hannaashkar/rv32i_cpu/docs/DEMO.md

# On-board demos — DE10-Lite quick guide

How to flash and drive the two board demos. The flashing procedure and the
LED walker are hardware-proven (2026-07-11); the MNIST demo is
lockstep-verified in simulation on both cores — its first board flash is
the acceptance step. **The MNIST bitstream now builds** — D024 first made
the design routable by moving the gshare PHT into M9Ks; D025 then moved the
6R/3W PRF into 18 M9Ks, D026 balanced the LQ selector, D027 balanced the SQ
selector, and D028 replaced the IQ port-1 clear-and-repick chain with a
cycle-exact top-two tree. D029 then proved that the memory/load-WB arm of the
generic EX bypass could never win, added a permanent source-use oracle, and
removed the dead mux input without changing a cycle.

The current production RTL top is merged and pushed at baseline **`3c3171f`**
(GitHub Actions run **29368469898 green**). It fits at **34,945 / 49,760 LEs
(70%)**, uses **15,140 registers, 632,444 memory bits, and 16 multiplier
elements**, and reaches **31.29 MHz** slow-85C Fmax. The actual PLL-/2 build
closes at **25 MHz** with **+8.045 ns** slow-85C setup slack; hold, recovery,
and removal are also positive, and every path is constrained. Both full
lockstep gates pass, and line coverage is **99.3% (1596/1607)** across 61
programs per core. Freshness-clean D029 MNIST `.sof` and `.pof` images were
assembled from MIF stamp `mlp`, but remain **unflashed**. No JTAG hardware was
available on 2026-07-15. Hardware truth is still the earlier 16.67 MHz
LED-walker/CFM image; MNIST has not run on silicon. Before
D024 it failed to route at 96% LEs — if you are on an older checkout and hit
"Can't route", that is why. If anything surprises you, the board state
section at the bottom is the first thing to check.

The board top (`rtl/top/de10_top.v`) is the **2-wide out-of-order core**
with the store-set predictor and the NPU. The current source is configured for
**25 MHz** (PLL /2 from the 50 MHz oscillator); this is timing-clean but not
yet hardware-confirmed. It is a 50% configured-clock increase over the
hardware-proven 16.67 MHz image. Which *program* the FPGA runs is decided at
compile time by the MIF images in `synth/`:

| `make` target | Program in the bitstream |
|---|---|
| `make mif` (default) | **MNIST demo** — switch-selected digit recognition |
| `make mif MIF_PROG=demo` | LED walker (the D022 bring-up acceptance test) |

After switching MIFs, recompile in Quartus (Processing → Start Compilation)
and reflash. The `.mif` files are checked in, so a fresh clone builds the
MNIST demo without any software toolchain.

## Flashing (Quartus Programmer GUI)

1. Board on, USB cable in. Open Quartus → **Tools → Programmer**.
2. **Hardware Setup…** → select `USB-Blaster [USB-0]` → Close.
   (Missing? Install the driver from
   `C:\intelfpga_lite\20.1\quartus\drivers\usb-blaster` via Device Manager.)
3. **Auto Detect** → the chain shows one `10M50DA` device.
4. **Change File…** → `synth/output_files/rv32i_cpu.sof` → tick
   **Program/Configure** → **Start**. Seconds later the design is live.
   `.sof` = volatile: lost on power-cycle.
5. To make it permanent: **Change File…** → `rv32i_cpu.pof`, tick
   **Program/Configure** + **Verify**, **Start** (~1 min). The design now
   boots from the MAX 10's internal flash on power-up, no PC needed.

CLI equivalent, from `synth/`:
`quartus_pgm -m jtag -o "p;output_files/rv32i_cpu.sof"` (or `"pv;...pof"`).

## The MNIST demo (D023)

At power-up / reset (KEY0) the program first **self-tests**: it classifies
all 8 built-in images and lights one LED per image as a progress bar. Then
it enters the interactive loop:

- **SW[2:0]** selects one of 8 handwritten-digit images (from the MNIST
  test set, baked into the data memory at synthesis).
- The CPU drives the NPU through the two matrix multiplies of a quantized
  784→32→10 network (~47k cycles ≈ 1.9 ms at the configured 25 MHz;
  simulation-derived until the board acceptance run) and shows:

```
  HEX5          HEX2      HEX0
  image number  label     prediction
  (switches)    (truth)   (the network's answer)
```

- **LEDR9** lights when prediction == label. **LEDR[7:0]** shows which
  image is selected. With the shipped weights all 8 images classify
  correctly, so HEX2 and HEX0 always match — flip switches and watch the
  answer track the truth.

Once flashed, this will exercise end-to-end on silicon: the banked M9K
instruction ROM, the MIF-initialized 64 KB block-RAM data memory (weights
present at power-up — there is no loader), the OoO core's IO-ordering
interlocks against a busy NPU, the systolic array itself, and the new
7-segment MMIO path. Until that acceptance step, these are simulation +
fit/STA claims, not an on-board inference claim. The same binary's self-test
phase runs in the Verilator regression
(`make npu-mlp-board[-ooo]`), lockstep-compared against the golden model.

## The LED walker (D022 bring-up test)

A single lit LED walks LEDR0→LEDR9 and back, self-paced in software.
Boring on purpose: every instruction fetch crosses the even/odd M9K banks
and the parity crossbar, so a steady walk is the acceptance test for the
banked instruction memory. Use it when bisecting a board problem — if the
walker runs, fetch/PLL/timing are healthy.

## Board state notes

- Displays dark + LEDs dead → press KEY0 (reset). Still dead → reflash.
- The last documented `.pof` programmed and verified in the MAX 10 flash is
  the earlier 16.67 MHz OoO LED walker/CFM image—not D029 and not MNIST
  inference. Check `git log synth/` to correlate any later manually
  programmed bitstream.
- As of 2026-07-15 no JTAG hardware was available, so the production 25 MHz
  `.sof`/`.pof` could not yet be accepted on the physical board.
- Pin assignments in `synth/rv32i_cpu.qsf` are copied from the proven
  build and are **not to be edited**; the HEX0-5 pins (added 2026-07-11,
  D023) were verified against two independent DE10-Lite references.
