hannaashkar/rv32i_cpu/docs/AUDIT-2026-07-11.md

# Full-project audit — 2026-07-11

Method: 8-dimension multi-agent audit (RTL area, timing, Quartus settings,
build system, verification, software, docs, hygiene); every medium/high
finding adversarially verified against the actual files/reports by an
independent checker before inclusion. 65 raw findings → **36 confirmed**,
2 refuted (both were already-documented deliberate calls), 27 minor.

Evidence base: the FAILED D023 fit (`synth/output_files/rv32i_cpu.fit.rpt`,
routing congestion at 96% LEs, A&S 53,200 LEs) — first time the per-entity
resource table was actually read.

Legend: **[H]**anna decision (microarchitecture) / **[C]**laude
(infrastructure). Status boxes updated as items land.

**Current production status (2026-07-15):** verification hardening and
D026–D029 are merged and pushed at RTL baseline **`3c3171f`**. GitHub Actions
run **29368469898 is green**. The complete
pre-merge feature stack is backed up on origin as `codex/load-wb-bypass-cut`
at **`fe3cfb0`**. Fresh PLL-/2 25 MHz MNIST programming files exist but remain
unflashed because no JTAG hardware was available on 2026-07-15. The physical
truth remains the earlier 16.67 MHz OoO LED-walker/CFM image.

---

## 1. Strategy-changing discoveries (area)

The per-entity fitter table rewrites the shrink plan — there are TWO LE pigs,
not one, and together they are ~44% of the 10M50:

| Entity | Fitted LCs | Regs | Root cause |
|---|---|---|---|
| `gshare_bp:BP0` | **11,137** (fit.rpt:1440) | 5,926 | PHT-side read/update networks; PHT duplicated per read port |
| `ooo_prf:PRF0` | **10,947** (fit.rpt:1507) | 2,048 | 64×32 flop array, 6 async read ports (`rd_bypass`, ooo_prf.v:35-51), 3 write ports |
| `ooo_iq:IQ0` | 8,378 (historical D023 audit); **8,565 on D028** | 2,720 | 162-bit uop payload muxed 16:1 on 3 select ports; D028 top-two timing tree adds no state |
| flat `ooo_cpu` | 14,132 | — | incl. ~3k LEs of RAT checkpoints (8×192b + dual rat_after0/1 snapshot networks, ooo_cpu.v:438,601-611) |

- [x] **[H] gshare shrink — CORRECTED AIM.** The BTB data arrays are
  **already M9K** in this build (btb_target/btb_tag/btb_cond each show
  0 LCs — Quartus auto-mapped altsyncram). The 11,137 LCs are PHT-side.
  Design options must target the PHT read/update path — not the BTB.
  **DONE 2026-07-12 (D024, branch `gshare-m9k-pht`): Hanna picked A1;
  even/odd banked M9K PHT shipped. A&S 53,200 → 46,620 LEs (−6,580,
  12.4% of the device), registers 18,976 → 16,995, PHT in 2 M9Ks.
  CoreMark IPC 1.026 KEPT (official CRCs, 432.8M instructions lockstep-
  clean); OoO 19/19+40/40+25/25+25/25-vio. INV-G1 + INV-G2 self-checks
  armed. Board fit re-run to unblock the D023 demo.** See DECISIONS.md
  D024 / docs/GSHARE_SHRINK.md.
- [x] **[H] PRF → M9K via LVT replication — DONE D025.** 18 M9K banks +
  register LVT + folded reads + exact direct/shadow write-first bypass;
  **−8,895 LEs (43,609 → 34,714, 88% → 70%)**, IPC/cycles unchanged.
  See DECISIONS D025 and `docs/PRF_SHRINK.md`.
- [ ] **[H] IQ payload split** (wakeup array vs payload RAM). 111 of the
  162 uop bits (U_IMM/U_PC/U_PNPC/U_GHR/U_RS1A) are never consulted by
  scheduling logic — classic payload-RAM split. Est. ~3k LEs; also
  de-risks the future 2-stage scheduler (less state to pipeline).
- [ ] **[H] Checkpoint slimming**: NCHKPT=4 (A/B the dispatch-stall cost),
  or M9K checkpoint file (+1 mispredict cycle), or drop the second
  same-cycle checkpoint port (delete rat_after1 network). ~1-3k LEs.
- [ ] **[C] Async resets on pure payload arrays** (IQ `u[]`, ex_a/ex_b,
  wb_val, dr_* payload, SQ addr/data, rob_pc — ooo_iq.v:270-276,
  ooo_cpu.v:1167-1193, ooo_sq.v:157-164) block RAM extraction and bloat
  the reset net. Valid-bit reset alone is architecturally sufficient.
  Mechanical, lockstep-verifiable, one module per commit — but Hanna
  ACKs the list first (X-semantics change in 4-state sims).

Delivered result from the two dominant storage conversions plus the D026 LQ,
D027 SQ, D028 IQ trees, and D029 dead-bypass cut: the routed production MNIST
board top is **34,945 LEs (70%)**, with routing slack restored. D029's full
verification, coverage, reportable CoreMark, and production CI gates are green.
Actual PLL-/2 fit/STA closes at 25 MHz with +8.045 ns slow-85C setup slack;
fresh MNIST `.sof`/`.pof` images are assembled and freshness-clean but
unflashed.

## 2. Timing truths

- [x] **[C] Re-run fit + STA after the storage shrinks.** D025 reported
  **23.51 MHz Fmax** and +17.47 ns slack at the 16.67 MHz board clock.
  All top-20 paths crossed the ~41.9 ns `dmem → load bypass → store AGU →
  LQ oldest-match → rob_poison` chain.
- [x] **[H] LQ violation-path redesign — DONE D026.** The serial selector is
  now an exact 8→4→2→1 parallel match/min-age tree with the old scan retained
  as a simulation oracle. Fmax **23.51 → 25.10 MHz (+6.8%)**; LQ is absent
  from all top-20 paths. B015 was found and fixed by the new LQ unit model.
- [x] **[H] SQ forwarding/replay selector — DONE D027.** The serial
  youngest-older scan is now an exact parallel-candidate + balanced 8→4→2→1
  max-age tree. The old scan remains a live Verilator oracle. `sq-tb` passes
  300,087 cycles / 300,088 queries / 45,313 forwards / 90,252 conflicts /
  36,668 drains / 2,382 flushes, including mandatory occupancy 0–8,
  one/two/final-slot allocation, SB/SH/SW, multi-match, backpressure,
  flush/wrap, and winner-leaf 0–7 bins. SQ cost is 924 mapped combinational
  LEs / 596 registers and 1,024 total fitted LCs / 596 registers; no serial SQ
  node remains in the top 20. Both cores pass 20/20 directed+C, 40/40 rv32ui, 25/25
  base/system/NPU random, and 80/80 X-state runs; OoO also passes 25/25
  violation stress. Official reportable CoreMark is cycle-identical at
  1.422552 CoreMark/MHz, IPC 1.026, 506,197,207 cycles, and 519,453,600
  lockstep comparisons.
- [x] **[H] IQ port-1 select rewrite — D028 ROUTED + FULL GATES GREEN.**
  D027's 38.744 ns / 32-level top-20 family was the dependent
  `pick → clear → repick` path. D028 computes the oldest two ALU candidates in
  one balanced sorted-pair tree. INV-I1 retains the old topology as a live
  oracle; `iq-tb` passes 300,553 cycles / 74,571 complete-payload checks and
  every 3×16 winner leaf. Fmax is **27.02 MHz**, and the IQ is absent from all
  top-20 paths. Both cores pass 20/20 directed+C, 40/40 rv32ui, 25/25
  base/system/NPU random, and 80/80 X/reset; OoO additionally passes all three
  queue unit models and 25/25 violation stress, with zero lockstep divergence.
  Fresh coverage is 99.2% (1522/1534), 60 programs per core, zero failures;
  every D028 IQ addition is covered. Reportable 720-iteration CoreMark is
  cycle-exact to D027 at 1.422552 CoreMark/MHz, IPC 1.026, 506,197,207
  full-run cycles, and 519,453,600 lockstep comparisons, with official CRCs,
  reportable validation, and zero divergence. D028's merge gate is complete.
- [x] **[H] D029 load/JALR/redirect/PHT path — DEAD WB2 ARM CUT, FULL GATES
  GREEN.** The measured cone crossed the generic WB2 load-result EX bypass.
  Edge-by-edge scheduling/PRF proof showed that the load has already left WB
  before its earliest consumer reaches EX, so D029 removes only WB2 while
  retaining WB0/WB1. A permanent ROB-tagged exact source-use oracle models the
  former bypass priority and fatals if WB2 could win. Full verification and
  reportable CoreMark cover all six select-port/source bins with **zero WB2
  hits**; `load_wb_bypass.S` adds 24 focused checks. `hello.c` and CoreMark are
  cycle-exact. The old dmem family is absent from D029's top 20.
- [ ] **[H] True 2-stage issue-queue scheduler / readiness cut — NEW D029
  LIMITER.** D029's top-20 family is `rob_head → IQ readiness/operand select`,
  worst 31.517 ns. A registered scheduler remains a valid higher-frequency
  option, but its latency/IPC cost must be compared with a smaller relage/head
  dependency cut before changing the public issue timing.
- [x] **[H] D027 clock decision.** Keep the board at PLL /3 (16.67 MHz).
  D027 fits at 34,787 LEs / 95 M9Ks with Fmax 25.47 MHz, +20.745 ns setup at
  /3, +0.337 ns worst hold, every timing check positive, and zero
  unconstrained paths. That implies only **0.745 ns theoretical setup margin**
  at PLL /2, below the ≥3 ns slow-85C gate, so a /2 build was not attempted.
  Fresh /3 `.sof` and `.pof` images were assembled. Reconsider /2 after the IQ
  redesign.
- [x] **[H] D028 clock decision.** Keep PLL /3 again. D028 fits at 35,096 LEs
  with Fmax 27.02 MHz and +22.994 ns setup at /3; hold +0.372 ns, recovery
  +52.869 ns, removal +1.653 ns, every timing class positive, and zero
  unconstrained paths. Subtracting the 20 ns period change for PLL /2 leaves
  **+2.994 ns theoretical margin**, narrowly below the ≥3 ns gate. No D028
  /2 claim was made. A final post-RTL map+fit rerun exactly reproduced the
  documented numerical results; assembly
  at 22:44:32 completed with 0 errors / 0 warnings from MIF stamp `mlp`.
  Freshness-clean D028 MNIST `.sof`/`.pof` exist but remain unflashed, so
  hardware truth remains the earlier LED-walker/CFM image.
- [x] **[H] D029 clock decision — PROMOTE TO PLL /2 (25 MHz).** The post-cut
  PLL-/3 characterization reached Fmax 29.14 MHz and projected +5.678 ns at
  /2, clearing the predeclared gate. The actual PLL-/2 build then fit at
  **34,945/49,760 LEs (70%)**, restricted Fmax **31.29 MHz**, slow-85C setup
  **+8.045 ns**, hold **+0.339 ns**, recovery +34.440 ns, removal +1.506 ns,
  every timing class positive, and zero unconstrained paths. Assembly produced
  fresh MNIST `.sof`/`.pof` images. This is a verified 50% clock increase over
  /3 in the build evidence, but it remains unflashed; hardware truth is still
  the earlier 16.67 MHz OoO LED-walker/CFM image.
- [x] **[C] No fit/STA make target, no critical-path archiving** → added
  (`make synth-fit` / `synth-sta`, see Makefile).

## 3. Board-fit toolbox (next D023 compile attempt)

- [x] **[C] Router/placement effort knobs** (all were defaults on a
  routing-failing design): ROUTER_TIMING_OPTIMIZATION_LEVEL MINIMUM,
  PLACEMENT_EFFORT_MULTIPLIER 4.0, ROUTER_EFFORT_MULTIPLIER 4.0.
- [x] **[C] Area-driven synthesis knobs — A/B result: mostly a DEAD
  END.** `OPTIMIZATION_TECHNIQUE Area`/`AREA` is silently ignored by
  quartus_map for this MAX 10 project (settings report stays "Balanced",
  netlist bit-identical at 53,200 LEs under both spellings — do not
  re-add). `AUTO_RESOURCE_SHARING ON` applies and is LE-neutral here
  (kept; free on future RTL). The LE relief must come from the RTL
  levers in §1, not synthesis settings.
- [ ] **[C] dmem maximum_depth hint**: 64 M9Ks currently scattered across
  all 3 columns × full die height (fit.rpt:2299). Try
  `maximum_depth=2048` (or 1024) to reshape address/byte-enable fanout.
  NOTE: the old "8192" idea is a likely no-op (verified).
- [x] **[C] NUM_PARALLEL_PROCESSORS ALL** (was capping at 10/16 cores,
  warning every run).
- [x] **[C] ModelSim EDA netlist generation OFF** (45 MB synth/simulation
  per compile, project simulates only with Verilator).
- [x] **[C→H] Redundant unindexed KEY IO_STANDARD assignment** — DONE
  2026-07-12 with Hanna's explicit approval (one duplicate line removed,
  KEY[0]/KEY[1] and all location assignments untouched).
- Refuted/parked (already-documented gambles, do not re-litigate): image
  trim 32→8 (D023 gamble shelf), seed sweep (placement already escalated
  internally; failure is structural).

## 4. Verification gaps

- [x] **[C] Coverage collection is entirely missing** — DONE 2026-07-11,
  re-measured 2026-07-14: `make coverage` (line-coverage builds of both
  cores, 61 programs each, verilator_coverage merge) — **99.3% RTL line
  coverage (1596/1607 on D029, zero failures)**, with the D029 source-use
  oracle active and 11 documented lines remaining, published in
  docs/VERIFICATION.md. Still open as a
  follow-up: ifdef'd functional cover points (IQ full, SQ full,
  checkpoint-starve, LQ violation, RAS overflow...).
- [x] **[C] FENCE/ECALL/EBREAK/reserved opcodes never executed by any
  test** — DONE 2026-07-14. Directed `sys_nops.S` proves sequential/exact
  retirement and no register/CSR/memory side effects. Additive `--sys`
  random lane: 25/25 seeds on each core, 1,148 injected words per core,
  zero lockstep divergence; established default and `--vio` seed hashes
  stayed byte-identical. Both decode/control modules are now line-covered.
- [ ] **[H picks invariants / C encodes] Assertion coverage remains uneven in
  the highest-risk modules.** The SQ portion is delivered in D027: INV-S1
  checks the balanced selector against the old serial scan every query, while
  INV-S2/S3 check occupancy/live-entry consistency, unique full tags and
  window identity, committed-prefix ordering, fill/retire/flush legality,
  query color, forwarding/conflict implications, and drain validity. LQ, PRF,
  decode, gshare, RAT/freelist, and cross-module recovery gaps remain. D028
  adds IQ INV-I1, which compares both raw top-two winners and the consumed
  port-1 grant against the old clear-and-repick topology every cycle. D029
  adds INV-B0/B1: exact decoder source-use identity plus a live model of the
  former WB-bypass priority for every valid EX uop, with mandatory coverage of
  all six consumer operand positions. The broader item still remains open.
- [x] **[C] Divergence diagnostics are single-point** — DONE 2026-07-11:
  64-entry retired-instruction ring buffer + full ISS register dump on
  every mismatch path, `+trace_at=<cycle>` late-opened FST, and a
  permanent `+force_diverge=<n>` self-test (verified firing on both
  cores, exit 3 with full context).
- [ ] **[C] Random generator blind spots**: forward-only control flow (no
  loops, no call/return trees, no RAS-depth stress, JALR always +12).
  **NPU sub-gap DONE 2026-07-14:** additive `--npu` mode targets the
  B010/B011 ordering space with 282 adversarial bursts / 564 GO commands
  per core across 25/25 lockstep-clean seeds; golden default/`--vio`
  streams stayed byte-identical. Remaining: loop/call-tree/RAS modes.
- [x] **[C] Reset/X-state never randomized** — DONE 2026-07-14. Separate
  in-order/OoO models use `--x-assign unique --x-initial unique`; the full
  directed+C suite runs at four explicit `+verilator+rand+reset+2` seeds.
  Both cores passed 84/84 program-seed runs on D029, lockstep-clean. The lane
  is a permanent prerequisite of `make verify` / `make verify-ooo` and leaves
  deterministic benchmark models untouched.
- [ ] **[C] SIM_BIG_MEM means the synthesized memory geometry (board-
  depth, altsyncram arm) is never simulated** — add one board-geometry
  smoke lane.

## 5. Build system

- [x] **[C] Guard the two documented landmines** (were tribal knowledge,
  zero enforcement): VERILATOR_ROOT unset → silent bad build (now a hard
  make error with the fix command); TMP/TEMP backslash-form for
  riscv-gcc recipes (now defaulted as make variables).
- [x] **[C] .PHONY gaps**: regress/regress-isa/regress-rand/
  regress-rand-vio/verify/coremark/mlp-board were not phony (the -ooo
  aliases were — a stray file named `regress` silently skipped the gate).
- [x] **[C] make mif stale trap**: switching MIF_PROG did not invalidate
  MIF targets → stamp file added; the board can no longer silently ship
  the wrong program.
- [x] **[C] synth-check LE-budget gate** (the exact gate that missed the
  D020 capacity blowout): now parses "Total logic elements" from map.rpt
  and fails above LE_BUDGET (A&S pre-packing number; recent history:
  53,004 fitted at 97%, 53,200 failed routing → default budget 52,000).
- [ ] **[C] Parallelize the suites** (regress/isa/rand run serially in
  single-recipe for-loops; ~4-6× wall-clock available via per-test stamp
  targets + make -j).
- [x] **[C] regress iterates the *.hex glob** → stale hex from deleted
  tests kept "passing"; now driven from the source list.
- [x] **[C] coremark pipe swallowed the simulator exit status** (only the
  CRC grep gated) → fixed.
- [x] **[C] CI**: `.github/workflows/ci.yml` added 2026-07-11 (ubuntu:
  apt Verilator + xPack riscv-none-elf-gcc; directed + ISA + trimmed
  random suites, both cores, lockstep-checked). First green GitHub run is
  confirmed on D025/main (`ab79b50`, run 29202181037). The D026–D029
  production merge is also green on `main` (`3c3171f`, run **29368469898**).
- [ ] **[C] Verilator models don't rebuild on VFLAGS/Makefile change**
  (stamp-file pattern exists for CFLAGS only).

## 6. Board-demo hardening (before the MNIST video)

- [x] **[H] SW switches have NO synchronizer** — DONE 2026-07-12
  (Hanna-approved): 2-flop reset-free sync in mmio.v, read mux returns
  the synchronized copy. Suites green both cores, demo cycle counts
  unchanged.
- [ ] **[C] NPU-ID/self-test failure is invisible on the bench** (parks
  with dark HEX = indistinguishable from a dead bitstream,
  mlp_board.c:99). Drive an error pattern (E-1/E-2 + fail count) first.
- [x] **[C] KEY0 warm reset silently corrupts .data** — DONE 2026-07-12
  (Hanna-approved): link_board.ld ASSERTs .data/.sdata empty (.srodata
  moved to .rodata first). mlp_board relinks clean; MIFs byte-identical.
- [x] **[H] In-order hazard unit spurious stalls** — DONE 2026-07-12
  (Hanna-approved): uses_rs1/uses_rs2 opcode qualifiers in
  hazard_unit.v. **Measured honestly: negligible on real workloads**
  (CoreMark 510,044,732 vs 510,056,361 baseline cycles ≈ −0.002%;
  hello.c unchanged; MLP demo −104 cyc) — the aliasing pattern is rare
  in gcc output. Kept as a decode-correctness cleanup; watch-list quirk
  closed.
- [ ] **[H, later] NPU is MMIO-store-bound**: ~3-5% of peak MAC
  throughput end-to-end (8 stores+GO per 4×4×4 tile; 10-cyc pass for 64
  MACs; MLP ideal ≈1,588 cyc vs measured 376k). Post-shrink options:
  deeper-K staging / dmem-side DMA burst loader / 8×8 array (64 DSPs).

## 7. Docs debt

- [x] **[C] docs/OOO.md** — superseded-in-part banner added (2026-07-11)
  pointing at STORESET.md + D020/D021; full params-table refresh still
  worth doing when the memory model next changes.
- [x] **[C] D023 README/DEMO routing truth** — recorded the then-current 96%
  routing blocker. Superseded by D024–D029: the D029 MNIST image now fits,
  closes actual PLL-/2 timing at 25 MHz, and has freshness-clean programming
  files; only physical flash remains.
- [x] **[C] docs/VERIFICATION.md** — "three vs five stimulus layers"
  contradiction fixed; coverage + divergence-diagnostics sections added
  with the measured 99.0% figure (2026-07-11).
- [ ] **[C] Branch cleanup:** D026–D029 and verification hardening are now
  merged into production `main` at `3c3171f`; no implementation remains
  stranded on the old stacked branches. The complete feature history is pushed
  at `origin/codex/load-wb-bypass-cut` (`fe3cfb0`). Delete old local waypoints
  only after a deliberate final hygiene review.
- [x] **[C] docs/book/ gitignored**; branch mlp-board-demo pushed to
  origin (was laptop-only).
- [x] **[C] Recruiter portfolio regenerated (2026-07-15):** the canonical
  tracked PDF is `output/pdf/rv32i_soc_portfolio.pdf`, built from
  `portfolio/evidence.json` by `scripts/build_portfolio.py`. It includes the
  final D024–D029 production evidence, green CI run, and explicit 25 MHz
  build-vs-silicon caveat. `docs/CAREER_PACKET.md` supplies résumé, LinkedIn,
  and interview-ready copy. The ignored `docs/book/` copy is retired/stale.

## Verified clean (don't re-audit)

SQ/LQ/store-set CAMs measured-small; SoC periphery (MMIO/CSR/ALU/glue)
is a dead end; SDC is complete — no legitimate multicycle exceptions
exist; the 14 in-order RTL files in the QSF are swept from the board
netlist (cost: compile time only); in-order register_file/
branch_predictor are fabric-only by construction (matters only if the
in-order core returns to the board top).

## Minor shelf (low-impact, grab-bag)

chk_ghr written never read; dead ooo_cpu signals (lq_flush_pc, wb_ld[],
p0_zero/p1_zero, U_HASCHK); NPU accumulators provably boundable to 25
bits (~150-200 LEs); PLL ratio hard-coded in defparam (in-order/OoO top
swap trap); board memory sizes hand-maintained in 3 places; 316 B dead
libmin string code (no gc-sections); classify() re-zeroes columns (~2.4k
dead stores/image); train_mlp gates are assert-based (stripped under
-O); rob_pc reads nearly dead in synthesis.
