hannaashkar/rv32i_cpu/rtl/ooo/ooo_iq.v

// ============================================================================
// ooo_iq — unified 16-entry issue queue (decision D013)
//
// Purpose:    Holds dispatched uops until their operands are ready, then
//             selects up to 3 per cycle, oldest-first, one per port:
//               port0: branches/JALR, falls back to plain ALU ops
//               port1: ALU ops + CSR ops (csr_file is wired to port1)
//               port2: loads/stores
// Scheduling contracts (docs/OOO.md):
//   * ALU/branch/store grants broadcast their dest tag AT SELECT — a
//     dependent can be selected the very next cycle (zero-bubble chains
//     via the EX bypass network). Loads broadcast at WRITEBACK instead
//     (external wkl bus) because a load may replay.
//   * Entries deallocate at select, except loads which set `issued` and
//     deallocate at WB-success (ldone) or re-arm on replay (rep).
//   * A mem op is eligible only when its dispatch-time wait mask is 0
//     (D021: the top encodes the load-speculation policy in the mask
//     value — 0 / full older-unknown-store mask / one-hot store-set
//     prediction). The mask is snapshotted at dispatch and ANDed each
//     cycle with the SQ's current unknown mask — bits only ever clear,
//     and a reused SQ slot can never re-set a bit (a store reusing a
//     slot is younger than this waiter by construction).
//   * Age = 6-bit ROB-tag distance from the ROB head tag.
// ============================================================================
`include "ooo_uop.vh"

module ooo_iq (
    input  wire              clk,
    input  wire              reset,

    // ROB head tag for age comparison
    input  wire [5:0]        head_tag,

    // dispatch (slot0 older than slot1)
    input  wire              disp0_en,
    input  wire [`UOPW-1:0]  disp0_uop,
    input  wire              disp0_r1,     // ps1 ready at dispatch
    input  wire              disp0_r2,
    input  wire [7:0]        disp0_mask,   // loads: older-unknown-store mask
    input  wire              disp1_en,
    input  wire [`UOPW-1:0]  disp1_uop,
    input  wire              disp1_r1,
    input  wire              disp1_r2,
    input  wire [7:0]        disp1_mask,
    output wire              free_ge1,
    output wire              free_ge2,

    // SQ current unknown-address mask (valid & ~addr_known)
    input  wire [7:0]        sq_unknown,
    // raw variant without the same-cycle fill bypass — consumed ONLY by
    // the simulation invariant check at the bottom; unused in synthesis
    input  wire [7:0]        sq_unknown_raw,

    // load writeback tag broadcast (external wakeup)
    input  wire              wkl_en,
    input  wire [5:0]        wkl_tag,

    // load replay / load done (by ROB tag)
    input  wire              rep_en,
    input  wire [5:0]        rep_tag,
    input  wire              ldone_en,
    input  wire [5:0]        ldone_tag,

    // squash: kill entries strictly younger than flush_tag (branch mispredict)
    input  wire              flush_en,
    input  wire [5:0]        flush_tag,
    // full flush (load-ordering-violation flush-at-head, D020): clear EVERY
    // resident entry. A tag-relative "younger than head-1" trick cannot express
    // "all" in modular ROB-tag arithmetic (relage is 6-bit, so > 63 is never
    // true), so the violation flush needs its own unconditional clear — same
    // pattern the SQ (commit_tail4) and LQ (flush_all) already use.
    input  wire              flush_all,

    // selects
    output reg               sel0_v,
    output reg  [`UOPW-1:0]  sel0_uop,
    output reg               sel1_v,
    output reg  [`UOPW-1:0]  sel1_uop,
    output reg               sel2_v,
    output reg  [`UOPW-1:0]  sel2_uop
);

`include "ooo_pkg.vh"

    reg              v      [0:IQD-1];
    reg              issued [0:IQD-1];
    reg              r1     [0:IQD-1];
    reg              r2     [0:IQD-1];
    reg  [7:0]       mask   [0:IQD-1];
    reg  [`UOPW-1:0] u      [0:IQD-1];

    integer i;

    // ------------------------------------------------------------------
    // eligibility
    // ------------------------------------------------------------------
    wire [IQD-1:0] elig_br, elig_alu, elig_mem;
    wire [5:0]     relage [0:IQD-1];

    genvar g;
    generate
        for (g = 0; g < IQD; g = g + 1) begin : ELIG
            wire ready = v[g] && !issued[g] && r1[g] && r2[g];
            wire is_ctrl = u[g][`U_ISBR] | u[g][`U_ISJALR];
            wire is_mem  = u[g][`U_ISLOAD] | u[g][`U_ISSTORE];
            // A mem op issues only once its dispatch-time wait mask has
            // decayed to 0 (D021). The mask VALUE encodes the policy — the
            // top dispatches 0 (speculate now), the full older-unknown-store
            // mask (conservative, D020 SPEC_LOADS=0), or a one-hot predicted
            // producer store (store-set). Loads AND stores share the gate;
            // non-predicted stores dispatch mask=0, so store behavior is
            // unchanged. The LQ violation CAM still repairs any under-wait.
            assign elig_br[g]  = ready && is_ctrl;
            assign elig_alu[g] = ready && !is_ctrl && !is_mem;
            assign elig_mem[g] = ready && is_mem && (mask[g] == 8'b0);
            assign relage[g]   = u[g][`U_TAG] - head_tag;
        end
    endgenerate

    // oldest-first pick over an eligibility vector.
    //
    // TIMING (D019, increment 1a): the previous version was a 16-deep serial
    // min-chain — each iteration's winner fed the next, so synthesis built a
    // ~16-level ripple that dominated the OoO critical path (the 8.42 MHz
    // Fmax cap, D018). This is a *balanced log-depth reduction tree* that
    // returns the BIT-IDENTICAL result in ~4 combine levels instead of 16.
    //
    // Each leaf is a candidate packed as {found, age[5:0], idx[3:0]} (11b).
    // `cmb2` combines two candidates keeping the OLDER (smaller relage), and
    // on an age TIE keeps the LEFT (lower-index) operand — which reproduces
    // the serial loop's strict `<` tie-break (first/lowest index at the min
    // age wins) exactly, so the grant index is unchanged and the schedule is
    // cycle-for-cycle identical (IPC-neutral). Verified by lockstep.
    localparam CANDW = 11;                 // {found(1), age(6), idx(4)}

    function [CANDW-1:0] cmb2;             // combine two candidates
        input [CANDW-1:0] a;               // left  (lower index range)
        input [CANDW-1:0] b;               // right (higher index range)
        reg a_f, b_f;
        reg [5:0] a_age, b_age;
        begin
            a_f = a[10]; b_f = b[10];
            a_age = a[9:4]; b_age = b[9:4];
            // keep b only if a is empty, or b is strictly older than a.
            // (strict `>` for a's age => on a tie, keep a = the left/lower
            //  index => matches the serial loop's `relage[k] < best`.)
            if (!a_f)                       cmb2 = b;
            else if (b_f && (a_age > b_age)) cmb2 = b;
            else                            cmb2 = a;
        end
    endfunction

    function [4:0] pick;  // returns {found, idx[3:0]}
        input [IQD-1:0] e;
        // leaf candidates
        reg [CANDW-1:0] c  [0:15];
        // tree levels (16 -> 8 -> 4 -> 2 -> 1)
        reg [CANDW-1:0] l8 [0:7];
        reg [CANDW-1:0] l4 [0:3];
        reg [CANDW-1:0] l2 [0:1];
        reg [CANDW-1:0] top;
        integer j;
        begin
            for (j = 0; j < 16; j = j + 1)
                c[j] = {e[j], relage[j], j[3:0]};   // found=e[j]; age; index
            for (j = 0; j < 8; j = j + 1)
                l8[j] = cmb2(c[2*j], c[2*j+1]);
            for (j = 0; j < 4; j = j + 1)
                l4[j] = cmb2(l8[2*j], l8[2*j+1]);
            for (j = 0; j < 2; j = j + 1)
                l2[j] = cmb2(l4[2*j], l4[2*j+1]);
            top = cmb2(l2[0], l2[1]);
            pick = {top[10], top[3:0]};              // {found, idx}
        end
    endfunction

    // port0: prefer control ops; otherwise oldest plain ALU op.
    // CSR ops must issue on port1 (csr_file lives there): exclude them
    // from the port0 fallback set
    wire [4:0] p_br = pick(elig_br);
    wire [IQD-1:0] elig_alu_noncsr;
    generate
        for (g = 0; g < IQD; g = g + 1) begin : NC
            assign elig_alu_noncsr[g] = elig_alu[g] && !u[g][`U_ISCSR];
        end
    endgenerate
    wire [4:0] p_alu0nc = pick(elig_alu_noncsr);
    wire       gr0_v    = p_br[4] | p_alu0nc[4];
    wire [3:0] gr0_i    = p_br[4] ? p_br[3:0] : p_alu0nc[3:0];

    // port1: oldest ALU/CSR excluding port0's grant.
    //
    // D019 increment 1b removed the dependency on port0's *actual* grant by
    // precomputing the first and second ALU candidates, then choosing between
    // them with a terminal mux.  Its second candidate still depended on the
    // first winner's one-hot clear, however; D027 routed STA exposed that
    // remaining clear-and-repick serialization and D028 removes it below.
    //
    // Set semantics preserved EXACTLY: port1 = oldest ALU/CSR excluding
    // port0's actual grant. Port0 only ever removes an ALU entry from the
    // set when it took that exact ALU op — so substitute the 2nd-oldest ONLY
    // when gr0 took the 1st-oldest ALU index. When port0 took a BRANCH,
    // gr0_i is not an elig_alu member at all, so the exclusion was a no-op in
    // the old code too, and port1 correctly gets the oldest ALU (p_alu_1st).
    // Verified equivalent by lockstep (not by inspection).
    // D028 increment 1: D019 still formed its second eligibility vector from
    // the first winner and then ran a second four-level pick tree.  Post-fit
    // STA exposed that first-pick -> one-hot-clear -> second-pick chain as the
    // complete top-20 critical-path family.  pick2() is one balanced top-two
    // tournament: each node merges two sorted {oldest, second-oldest} pairs.
    // No state or latency is added, and INV-I1 below keeps the old topology as
    // a live simulation oracle for every winner in every cycle.
    localparam PAIRW = 2*CANDW;

    function [PAIRW-1:0] pair_cmb2;
        input [PAIRW-1:0] a;               // lower-index half
        input [PAIRW-1:0] b;               // higher-index half
        reg [CANDW-1:0] a1, a2, b1, b2;
        reg [CANDW-1:0] first, second;
        begin
            a1 = a[PAIRW-1:CANDW]; a2 = a[CANDW-1:0];
            b1 = b[PAIRW-1:CANDW]; b2 = b[CANDW-1:0];
            first = cmb2(a1, b1);
            // If the left winner survives, the runner-up is the better of
            // left's runner-up and right's winner; otherwise the symmetric
            // pair applies.  Each cmb2 still sees lower indices on its left.
            if (first == a1) second = cmb2(a2, b1);
            else             second = cmb2(a1, b2);
            pair_cmb2 = {first, second};
        end
    endfunction

    function [9:0] pick2;
        input [IQD-1:0] e;
        reg [PAIRW-1:0] c  [0:15];
        reg [PAIRW-1:0] l8 [0:7];
        reg [PAIRW-1:0] l4 [0:3];
        reg [PAIRW-1:0] l2 [0:1];
        reg [PAIRW-1:0] top;
        integer j;
        begin
            for (j = 0; j < 16; j = j + 1)
                // The invalid runner-up carries the same age/index.  If a
                // subtree has fewer than two candidates, cmb2 therefore
                // preserves pick()'s otherwise-unused invalid index exactly.
                c[j] = {{e[j], relage[j], j[3:0]},
                        {1'b0, relage[j], j[3:0]}};
            for (j = 0; j < 8; j = j + 1)
                l8[j] = pair_cmb2(c[2*j], c[2*j+1]);
            for (j = 0; j < 4; j = j + 1)
                l4[j] = pair_cmb2(l8[2*j], l8[2*j+1]);
            for (j = 0; j < 2; j = j + 1)
                l2[j] = pair_cmb2(l4[2*j], l4[2*j+1]);
            top = pair_cmb2(l2[0], l2[1]);
            pick2 = {top[2*CANDW-1], top[CANDW+3:CANDW],
                     top[CANDW-1],   top[3:0]};
        end
    endfunction

    wire [9:0] p_alu_top2 = pick2(elig_alu);
    wire [4:0] p_alu_1st = p_alu_top2[9:5];
    wire [4:0] p_alu_2nd = p_alu_top2[4:0];

    wire port0_took_alu1st = gr0_v && p_alu_1st[4] && (gr0_i == p_alu_1st[3:0]);
    wire [4:0] p_alu1 = port0_took_alu1st ? p_alu_2nd : p_alu_1st;

    // port2: oldest memory op
    wire [4:0] p_mem = pick(elig_mem);

    // ------------------------------------------------------------------
    // select-time wakeup tags (internal: port0/port1 grants; stores on
    // port2 have wr=0 so they never broadcast; loads use the WB bus)
    // ------------------------------------------------------------------
    wire        wk0_en  = gr0_v && u[gr0_i][`U_WR];
    wire [5:0]  wk0_tag = u[gr0_i][`U_PD];
    wire        wk1_en  = p_alu1[4] && u[p_alu1[3:0]][`U_WR];
    wire [5:0]  wk1_tag = u[p_alu1[3:0]][`U_PD];

    function wakes;
        input [5:0] tag;
        begin
            wakes = (wk0_en && wk0_tag == tag)
                 || (wk1_en && wk1_tag == tag)
                 || (wkl_en && wkl_tag == tag);
        end
    endfunction

    // ------------------------------------------------------------------
    // free-slot allocation for dispatch
    // ------------------------------------------------------------------
    reg [3:0] free0, free1;
    reg       f0v, f1v;
    always @(*) begin
        f0v = 1'b0; f1v = 1'b0; free0 = 4'd0; free1 = 4'd0;
        for (i = IQD - 1; i >= 0; i = i - 1)
            if (!v[i]) begin
                free1 = free0; f1v = f0v;
                free0 = i[3:0]; f0v = 1'b1;
            end
    end
    assign free_ge1 = f0v;
    assign free_ge2 = f0v && f1v;

    // ------------------------------------------------------------------
    // select outputs (registered grants would add a cycle; combinational
    // outputs latch into the RF stage registers in the top)
    // ------------------------------------------------------------------
    always @(*) begin
        sel0_v   = gr0_v;
        sel0_uop = u[gr0_i];
        sel1_v   = p_alu1[4];
        sel1_uop = u[p_alu1[3:0]];
        sel2_v   = p_mem[4];
        sel2_uop = u[p_mem[3:0]];
    end

    // ------------------------------------------------------------------
    // state update
    // ------------------------------------------------------------------
    always @(posedge clk or posedge reset) begin
        if (reset) begin
            for (i = 0; i < IQD; i = i + 1) begin
                v[i] <= 1'b0; issued[i] <= 1'b0;
                r1[i] <= 1'b0; r2[i] <= 1'b0;
                mask[i] <= 8'b0; u[i] <= {`UOPW{1'b0}};
            end
        end else begin
            // wakeups + mask decay on resident entries
            for (i = 0; i < IQD; i = i + 1) begin
                if (v[i]) begin
                    if (wakes(u[i][`U_PS1])) r1[i] <= 1'b1;
                    if (wakes(u[i][`U_PS2])) r2[i] <= 1'b1;
                    mask[i] <= mask[i] & sq_unknown;
                end
            end

            // deallocation at select (non-loads); loads mark issued
            if (gr0_v)     v[gr0_i]        <= 1'b0;
            if (p_alu1[4]) v[p_alu1[3:0]]  <= 1'b0;
            if (p_mem[4]) begin
                if (u[p_mem[3:0]][`U_ISLOAD]) issued[p_mem[3:0]] <= 1'b1;
                else                          v[p_mem[3:0]]      <= 1'b0;
            end

            // load replay / completion (by ROB tag)
            for (i = 0; i < IQD; i = i + 1) begin
                if (v[i] && u[i][`U_ISLOAD] && issued[i]) begin
                    if (rep_en   && u[i][`U_TAG] == rep_tag)
                        issued[i] <= 1'b0;
                    if (ldone_en && u[i][`U_TAG] == ldone_tag)
                        v[i] <= 1'b0;
                end
            end

            // dispatch (after dealloc so a freed slot is reusable next
            // cycle only — free list computed from registered v ensures
            // no same-cycle reuse of a granted slot)
            if (disp0_en && f0v) begin
                v[free0]      <= 1'b1;
                issued[free0] <= 1'b0;
                u[free0]      <= disp0_uop;
                r1[free0]     <= disp0_r1 || wakes(disp0_uop[`U_PS1]);
                r2[free0]     <= disp0_r2 || wakes(disp0_uop[`U_PS2]);
                mask[free0]   <= disp0_mask;
            end
            if (disp1_en && f1v) begin
                v[free1]      <= 1'b1;
                issued[free1] <= 1'b0;
                u[free1]      <= disp1_uop;
                r1[free1]     <= disp1_r1 || wakes(disp1_uop[`U_PS1]);
                r2[free1]     <= disp1_r2 || wakes(disp1_uop[`U_PS2]);
                mask[free1]   <= disp1_mask;
            end

            // squash LAST: overrides dispatch/wakeup of dying entries.
            // flush_all (violation flush-at-head) empties the whole IQ; it
            // takes priority over the tag-relative branch squash.
            if (flush_all) begin
                for (i = 0; i < IQD; i = i + 1) v[i] <= 1'b0;
            end else if (flush_en) begin
                for (i = 0; i < IQD; i = i + 1)
                    if (v[i] && ((u[i][`U_TAG] - head_tag)
                                 > (flush_tag - head_tag)))
                        v[i] <= 1'b0;
                // dispatching entries are younger than any resolving
                // branch by construction; kill them too
                if (disp0_en && f0v) v[free0] <= 1'b0;
                if (disp1_en && f1v) v[free1] <= 1'b0;
            end
        end
    end

`ifdef VERILATOR
    // D028 INV-I1: cycle-exact oracle for the top-two tournament.  Retain the
    // former clear-and-repick topology in simulation only and compare both
    // raw winners plus the architecturally consumed port-1 winner every edge.
    wire [4:0] p_alu_1st_old = pick(elig_alu);
    wire [IQD-1:0] onehot_1st_old = p_alu_1st_old[4]
                                      ? (16'b1 << p_alu_1st_old[3:0])
                                      : 16'b0;
    wire [4:0] p_alu_2nd_old = pick(elig_alu & ~onehot_1st_old);
    wire       port0_took_alu1st_old = gr0_v && p_alu_1st_old[4]
                                       && (gr0_i == p_alu_1st_old[3:0]);
    wire [4:0] p_alu1_old = port0_took_alu1st_old
                            ? p_alu_2nd_old : p_alu_1st_old;

    always @(posedge clk) if (!reset) begin
        if (p_alu_1st !== p_alu_1st_old
            || p_alu_2nd !== p_alu_2nd_old
            || p_alu1 !== p_alu1_old)
            $fatal(1, "ooo_iq INV-I1: top-two tournament != old repick");
    end

    // D021 INV-P5/P9: every resident wait-mask bit must denote a LIVE,
    // still-unknown SQ slot — the strictly-older continuous-occupant
    // property the mask-deadlock-freedom proof rests on (a bit pointing at
    // a dead or reused slot would be the B013 class of residual-state
    // bug). And only mem ops may carry wait masks.
    integer ak;
    always @(posedge clk) if (!reset) begin
        for (ak = 0; ak < IQD; ak = ak + 1) begin
            if (v[ak] && ((mask[ak] & ~sq_unknown_raw) != 8'b0))
                $fatal(1, "ooo_iq: wait-mask bit on a dead/known SQ slot");
            if (v[ak] && (mask[ak] != 8'b0)
                && !(u[ak][`U_ISLOAD] || u[ak][`U_ISSTORE]))
                $fatal(1, "ooo_iq: wait mask on a non-mem uop");
        end
    end
`endif

endmodule
