hannaashkar/rv32i_cpu/rtl/core/id_ex_reg.v

module id_ex_reg (
    input clk,
    input reset,

    // Flush signal from hazard or branch misprediction logic
    input flush,

    // Hold signal (NPU interlock, D014): keeps the EX-stage instruction
    // in place while it waits for the NPU to go idle. Stall WINS over
    // flush — a simultaneous load-use flush must not erase the very
    // instruction that is waiting.
    input stall,

    // -------------------------------
    // Control signals coming from ID stage
    // -------------------------------
    input        RegWrite_in,
    input        MemRead_in,
    input        MemWrite_in,
    input        MemToReg_in,
    input        ALUSrc_in,
    input        ALUAPc_in,   // operand A = pc (AUIPC / jump link path)
    input        Branch_in,
    input        Jal_in,      // unconditional jump, target = pc+imm
    input        Jalr_in,     // unconditional jump, target = rs1+imm
    input        Csr_in,      // CSR instruction (Zicsr, D012)
    input        valid_in,    // architecturally real instruction (D012)
    input  [2:0] ALUOp_in,

    // -------------------------------
    // Data and instruction fields from ID stage
    // -------------------------------
    input [31:0] pc_in,
    input [31:0] rs1_data_in,
    input [31:0] rs2_data_in,
    input [31:0] imm_in,
    input [4:0]  rs1_in,
    input [4:0]  rs2_in,
    input [4:0]  rd_in,
    input [2:0]  funct3_in,
    input [6:0]  funct7_in,

    // Branch predictor info forwarded from Decode → Execute
    input         pred_takenD,
    input  [31:0] pred_targetD,

    // -------------------------------
    // Outputs into EX stage
    // -------------------------------
    output reg        RegWrite_out,
    output reg        MemRead_out,
    output reg        MemWrite_out,
    output reg        MemToReg_out,
    output reg        ALUSrc_out,
    output reg        ALUAPc_out,
    output reg        Branch_out,
    output reg        Jal_out,
    output reg        Jalr_out,
    output reg        Csr_out,
    output reg        valid_out,
    output reg [2:0]  ALUOp_out,

    output reg [31:0] pc_out,
    output reg [31:0] rs1_data_out,
    output reg [31:0] rs2_data_out,
    output reg [31:0] imm_out,
    output reg [4:0]  rs1_out,
    output reg [4:0]  rs2_out,
    output reg [4:0]  rd_out,
    output reg [2:0]  funct3_out,
    output reg [6:0]  funct7_out,

    // Predictor info latched into EX stage
    output reg        pred_takenE,
    output reg [31:0] pred_targetE
);

    // ---------------------------------------------------------
    // ID/EX pipeline register
    // Handles: reset, flush (bubble), and normal pipeline advance
    // ---------------------------------------------------------
    always @(posedge clk or posedge reset) begin
        if (reset) begin
            // Asynchronous reset clears the entire pipeline register
            RegWrite_out      <= 0;
            MemRead_out       <= 0;
            MemWrite_out      <= 0;
            MemToReg_out      <= 0;
            ALUSrc_out        <= 0;
            ALUAPc_out        <= 0;
            Branch_out        <= 0;
            Jal_out           <= 0;
            Jalr_out          <= 0;
            Csr_out           <= 0;
            valid_out         <= 0;
            ALUOp_out         <= 0;

            pc_out            <= 0;
            rs1_data_out      <= 0;
            rs2_data_out      <= 0;
            imm_out           <= 0;
            rs1_out           <= 0;
            rs2_out           <= 0;
            rd_out            <= 0;
            funct3_out        <= 0;
            funct7_out        <= 0;

            pred_takenE       <= 0;
            pred_targetE      <= 0;

        end else if (stall) begin
            // ---------------------------------------------------
            // Hold: the EX instruction stays put (no assignments)
            // ---------------------------------------------------
        end else if (flush) begin
            // -------------------------------------------------
            // Pipeline flush: insert a bubble into EX stage
            // Used for load-use hazards or branch misprediction.
            // Csr=0 kills any pending CSR side effect; valid=0 keeps
            // the bubble out of the instret count (D012).
            // -------------------------------------------------
            RegWrite_out      <= 0;
            MemRead_out       <= 0;
            MemWrite_out      <= 0;
            MemToReg_out      <= 0;
            ALUSrc_out        <= 0;
            ALUAPc_out        <= 0;
            Branch_out        <= 0;
            Jal_out           <= 0;
            Jalr_out          <= 0;
            Csr_out           <= 0;
            valid_out         <= 0;
            ALUOp_out         <= 0;

            pc_out            <= 0;
            rs1_data_out      <= 0;
            rs2_data_out      <= 0;
            imm_out           <= 0;
            rs1_out           <= 0;
            rs2_out           <= 0;
            rd_out            <= 0;
            funct3_out        <= 0;
            funct7_out        <= 0;

            pred_takenE       <= 0;
            pred_targetE      <= 0;

        end else begin
            // -------------------------------------------------
            // Normal pipeline progression: latch all inputs
            // -------------------------------------------------
            RegWrite_out      <= RegWrite_in;
            MemRead_out       <= MemRead_in;
            MemWrite_out      <= MemWrite_in;
            MemToReg_out      <= MemToReg_in;
            ALUSrc_out        <= ALUSrc_in;
            ALUAPc_out        <= ALUAPc_in;
            Branch_out        <= Branch_in;
            Jal_out           <= Jal_in;
            Jalr_out          <= Jalr_in;
            Csr_out           <= Csr_in;
            valid_out         <= valid_in;
            ALUOp_out         <= ALUOp_in;

            pc_out            <= pc_in;
            rs1_data_out      <= rs1_data_in;
            rs2_data_out      <= rs2_data_in;
            imm_out           <= imm_in;
            rs1_out           <= rs1_in;
            rs2_out           <= rs2_in;
            rd_out            <= rd_in;
            funct3_out        <= funct3_in;
            funct7_out        <= funct7_in;

            // Forward predictor state into EX stage
            pred_takenE       <= pred_takenD;
            pred_targetE      <= pred_targetD;
        end
    end

endmodule
