hannaashkar/rv32i_cpu/rtl/core/ex_mem_reg.v

module ex_mem_reg (
    input clk,
    input reset,

    // -----------------------------
    // Control signals coming from EX
    // -----------------------------
    input        RegWrite_in,
    input        MemToReg_in,
    input        MemRead_in,
    input        MemWrite_in,
    input        Branch_in,
    input        valid_in,           // real instruction, counted at retire (D012)

    // -----------------------------
    // Data signals from EX stage
    // -----------------------------
    input [31:0] alu_result_in,       // ALU result to be used in MEM/WB
    input [31:0] rs2_data_in,         // store data (rs2 forwarded)
    input        zero_in,             // ALU zero flag for branch logic
    input [31:0] branch_target_in,    // computed branch target
    input [4:0]  rd_in,               // destination register ID
    input [2:0]  funct3_in,           // access size/sign for MEM (loads/stores)
    input [31:0] pc_in,               // observability: lockstep co-sim compares
                                      // retirement PCs (pruned in synthesis)

    // -----------------------------
    // Outputs into MEM stage
    // -----------------------------
    output reg        RegWrite_out,
    output reg        MemToReg_out,
    output reg        MemRead_out,
    output reg        MemWrite_out,
    output reg        Branch_out,
    output reg        valid_out,

    output reg [31:0] alu_result_out,
    output reg [31:0] rs2_data_out,
    output reg        zero_out,
    output reg [31:0] branch_target_out,
    output reg [4:0]  rd_out,
    output reg [2:0]  funct3_out,
    output reg [31:0] pc_out
);

    // ---------------------------------------------------------
    // Pipeline register between EX and MEM
    // Captures all signals on rising clock edge
    // ---------------------------------------------------------
    always @(posedge clk or posedge reset) begin
        if (reset) begin
            // Clear all fields when reset is asserted
            RegWrite_out      <= 0;
            MemToReg_out      <= 0;
            MemRead_out       <= 0;
            MemWrite_out      <= 0;
            Branch_out        <= 0;
            valid_out         <= 0;

            alu_result_out    <= 0;
            rs2_data_out      <= 0;
            zero_out          <= 0;
            branch_target_out <= 0;
            rd_out            <= 0;
            funct3_out        <= 0;
            pc_out            <= 0;
        end else begin
            // Capture control signals
            RegWrite_out      <= RegWrite_in;
            MemToReg_out      <= MemToReg_in;
            MemRead_out       <= MemRead_in;
            MemWrite_out      <= MemWrite_in;
            Branch_out        <= Branch_in;
            valid_out         <= valid_in;

            // Capture data signals
            alu_result_out    <= alu_result_in;
            rs2_data_out      <= rs2_data_in;
            zero_out          <= zero_in;
            branch_target_out <= branch_target_in;
            rd_out            <= rd_in;
            funct3_out        <= funct3_in;
            pc_out            <= pc_in;
        end
    end

endmodule
