hannaashkar/rv32i_cpu/(commit log)

2026-07-03 refactor: reorganize into rtl/tb/sw/synth/docs layout
    Pure git-mv reorganization, no content changes:
    - rtl/core: pipeline, hazard/forwarding, branch predictor, ALU, regfile, decode
    - rtl/mem: imem, dmem
    - rtl/soc: mmio
    - rtl/top: de10_top (DE10-Lite board wrapper)
    - tb/legacy: original ModelSim testbench
2026-07-03 fix(rtl): remove dangling debug_x3 connection in cpu_pipeline
    register_file.v no longer has a debug_x3 port (removed in the Dec 10
    upload), but cpu_pipeline.v still connected it, so the design did not
    compile. LEDs are driven via MMIO, so the debug wire is dead — remove
    the wire, the port connection, and the stale comment.
    [cpu_pipeline.v]
2026-07-03 chore: add gitignore, Quartus synth project, and docs scaffolding
    - .gitignore: Quartus/sim/sw build artifacts, editor noise
    - synth/rv32i_cpu.qsf+.qpf: clean single-level Quartus project derived
    from the proven 2025-12-01 build (top de10_top, 10M50DAF484C7G);
    DE10-Lite pin assignments copied verbatim; sources point at ../rtl
    - docs/BUGLOG.md: bugs found so far (B001-B006) with root causes
    - docs/DECISIONS.md: D001-D005 (toolchain, repo home, RV32I stage,
    layout, debug_x3 removal)
    - README.md: project-structure section updated to the new layout
2026-07-03 docs: add CLAUDE.md project guide
    Condensed project rules (roadmap, division of labor, process), the real
    Windows-native environment (no WSL — see D001), verified design state,
    and a Current-status section updated each session.
2026-07-03 feat(tb): Verilator simulation environment with program loading
    - tb/verilator/sim_main.cpp: C++ harness; test-end protocol = store to
    magic MMIO address 0x40000008 (1 = PASS, else FAIL, timeout = exit 2);
    +imem=<hex> program loading, +trace FST waveforms, +max_cycles guard
    - rtl/mem/imem.v: hex-file program memory ($readmemh) replacing the
    hardcoded demo ROM; synthesis default sw/demo/led_demo.hex preserves the
    old bitstream behavior; +imem plusarg override in simulation
    - rtl/core/cpu_pipeline.v: verilator public_flat_rd marks on 4 signals
    (comments to Quartus) so the harness can watch the MEM-stage store bus
    - Makefile + scripts/make.cmd: sim/sw/test/run/wave/synth-check targets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
    [cpu_pipeline.v, imem.v, sim_main.cpp]
2026-07-03 fix(rtl): forward store data and add regfile write-read bypass
    Two RAW-hazard correctness fixes, each caught by sw/tests/store_fwd.S:
    - B007: EX/MEM now latches the forwarded rs2 (rs2_fwd_base) as store
    data instead of the raw ID/EX value, so a store immediately after its
    producer writes the fresh value (decision D011/F1).
    - B008 (found while verifying B007): the register file reads now bypass
    an in-flight writeback (write-first semantics). Without this, a
    consumer exactly 3 instructions behind its producer read a stale
    value - past EX forwarding range, but before the regfile write landed.
    Also: +verbose harness option traces stores, branch resolution, and the
    WB stage - this is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
    [cpu_pipeline.v, register_file.v, sim_main.cpp]
2026-07-03 feat(rtl): flat funct3 ALU decode with shifts, SLTU, SLTIU (D006/A2)
    - alu_ops.vh: shared operation encoding included by decoder and ALU
    - alu_control.v: decode funct3 directly; funct7[5] consulted only where
    the ISA defines it (R-type ADD/SUB, SRL/SRA). I-type immediates can no
    longer spoof SUB - fixes B004 structurally
    - alu.v: adds SLL/SRL/SRA via one shared reversed barrel shifter, SLTU,
    and PASS_B (reserved for LUI, D009)
    - control.v: I-type ALU ops now use the ITYPE decode class
    - sw/tests/alu_ops.S: 19 directed checks incl. B004 regression, shift
    corner cases (shamt masking, SRA sign, SRL of negative), unsigned
    compares, logic-op patterns
    - Makefile: 'make regress' runs ever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
    [alu.v, alu_control.v, control.v]
2026-07-03 feat(rtl): dedicated branch unit with all six conditions (D007/B2)
    - branch_unit.v: eq / signed-lt / unsigned-lt comparator on the forwarded
    operands, condition selected by funct3 (BEQ/BNE/BLT/BGE/BLTU/BGEU)
    - cpu_pipeline.v: branch_taken_ex now comes from the comparator, not the
    ALU zero flag - fixes the BNE-executes-as-BEQ quirk and takes the
    branch decision off the ALU path (shorter EX redirect path)
    - sw/tests/branch_ops.S: taken + not-taken for every condition with
    signed/unsigned boundary operands (-1 vs 1), equality edges, and a
    real backward-branch loop for the predictor
    Verified: regress 4/4 PASS; quartus_map 0 errors.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
    [branch_unit.v, control.v, cpu_pipeline.v]
2026-07-03 feat(rtl): LUI and AUIPC through the ALU (D009/D1)
    - sign_extend.v: U-type immediate ({instr[31:12], 12'b0})
    - control.v: LUI = new PASSB class (ALU passes the immediate through);
    AUIPC = ADD class with the new ALUAPc control routing pcE into ALU
    operand A. ALUOp class widened to 3 bits (alu_ops.vh)
    - id_ex_reg.v: carries ALUAPc, 3-bit ALUOp
    - cpu_pipeline.v: operand-A mux (pc vs forwarded rs1) - the same path
    jumps will reuse (D008/C1)
    - sw/tests/lui_auipc.S: LUI vs independently-built constants (sign bit
    set), li idiom (lui+addi), position-independent AUIPC delta checks,
    x0-write discard
    With LUI working, test exit sequences can use 'lui' directly instead of
    doubling chains.
    Ve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
2026-07-03 feat(rtl): JAL and JALR via the EX redirect path (D008/C1)
    - control.v: Jal/Jalr decode; JALR computes its target on the ALU
    (rs1+imm, rs1 forwarded normally)
    - sign_extend.v: J-type immediate; JALR shares the I-type immediate
    - id_ex_reg.v: carries Jal/Jalr into EX
    - cpu_pipeline.v: jumps are always-taken redirect instructions - they
    share the branch mispredict/redirect machinery and train the BTB, so
    repeat encounters cost zero cycles. JALR target LSB cleared per ISA.
    rd receives pc+4 through a new EX result mux, so link values forward
    to consumers like any ALU result
    - sw/tests/jump_ops.S: link-value checks (position-independent via
    auipc), wrong-path-never-commits checks, JAL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
    [control.v, cpu_pipeline.v, id_ex_reg.v, sign_extend.v]
2026-07-03 feat(rtl): byte/half loads and stores complete RV32I (D010/Eb)
    - dmem.v: word array with byte-lane write enables (SB/SH/SW via
    funct3[1:0] + addr[1:0]) and load extraction with sign/zero extension
    (LB/LBU/LH/LHU/LW); optional +dmem=<hex> data image; explicit
    clog2-wide index slice (closes the truncation quirk)
    - ex_mem_reg.v + cpu_pipeline.v: funct3 carried into MEM
    - imem/dmem: SIM_BIG_MEM (set by the Verilator build) selects 256KB
    memories for benchmarks in simulation; synthesis keeps small defaults
    - sw/tests/mem_ops.S: all byte lanes, both half lanes, sign vs zero
    extension, neighbor-preservation on SB/SH
    - docs: BUGLOG watch-list refresh (2 resolved, 2 new known quirks),
    CLA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
    [cpu_pipeline.v, dmem.v, ex_mem_reg.v, imem.v]
2026-07-03 feat(rtl): Zicsr scaffold with cycle/instret counters (D012)
    New csr_file module executes all six CSR instruction forms in EX, where
    nothing can be killed (no traps; mispredicts flush only IF/ID + ID/EX),
    so CSR writes commit non-speculatively. The read value returns through
    the existing EX result mux and forwards like any ALU result; the CSR
    address rides the I-type immediate bus (instr[31:20] == immE[11:0]).
    CSRs: cycle/cycleh + instret/instreth (64-bit, read-only; writes dropped
    until traps can be raised) and mscratch as the first writable CSR so the
    RW/RS/RC write path is tested logic, not dead scaffolding.
    instret counts real retirement: a 1-bit valid flag flows IF->WB through
    the pip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
2026-07-03 feat(sw): C runtime — crt0, Harvard linker layout, dmem data images
    The core is Harvard: fetches see only imem, loads/stores only dmem (or
    MMIO). Both memories index by low address bits (aliasing), so data
    sections get the conventional VMA 0x10000000 — which lands on dmem word
    0 — while .text stays at 0 in imem. One elf produces two images:
    objcopy extracts .text -> <prog>.text.hex (+imem=) and the initialized
    data sections -> <prog>.data.hex (+dmem=). A 4-byte .dmem_origin
    sentinel emitted by crt0 pins the data image to exactly 0x10000000;
    without it a program with an empty .rodata would have its whole data
    image shifted and every global would load garbage.
    crt0.S sets sp (top of dme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
2026-07-03 feat(sw): CoreMark port and measured baseline — 1.177 CoreMark/MHz, IPC 0.849
    Vendor EEMBC CoreMark unmodified (Apache-2.0) in sw/coremark/ with an
    rv32 port layer:
    - timing: the cycle CSR (D012) — cycle-accurate, identical in sim and
    on the DE10-Lite; EE_TICKS_PER_SEC = the board 50 MHz clock
    - console: ee_printf backend stores bytes to 0x40000010; the Verilator
    harness snoops the MEM-stage store bus and prints them. mmio.v
    ignores the address, so no RTL change and a no-op on real hardware
    - MEM_STATIC, SEED_VOLATILE, MAIN_HAS_NOARGC (crt0 calls main(void))
    make coremark runs 600 iterations = 10.2 simulated seconds, satisfying
    CoreMark 10-second reporting rule (which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
2026-07-03 feat(tb): golden-model lockstep co-simulation (RV32I ISS)
    New tb/verilator/iss.h: a ~300-line RV32I+Zicsr instruction-set
    simulator. The harness steps it once per retired instruction (validW)
    and compares the retired pc, the register writeback (rd + value), and
    every store in program order (address, size, full rs2 word — so
    forwarding bugs like B007/B008 are caught at the exact instruction).
    First divergence aborts with a diff dump, exit code 3.
    The model replicates this SoC exactly, documented quirks included
    (memory aliasing, word-only MMIO loads, misaligned lane math, JALR &~1,
    unknown-ops-as-NOPs). cycle/instret CSR reads are microarchitectural,
    so the RTL value is injected into the m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
    [cpu_pipeline.v, ex_mem_reg.v, iss.h, mem_wb_reg.v, sim_main.cpp]
2026-07-03 feat(verif): constrained-random test generation, lockstep-checked
    scripts/gen_random_test.py emits ready-to-run imem hex images (no
    assembler in the loop): weighted mix of all RV32I ALU ops, all load/
    store sizes at random possibly-misaligned non-IO addresses, all six
    branches (forward-only, so programs terminate by construction), JAL,
    AUIPC+JALR pairs, and Zicsr ops. Correctness checking lives entirely in
    the golden-model lockstep — programs need no self-checks, so every
    instruction is a check.
    make regress-rand: 25 seeds x 3000 instructions, reproducible by seed.
    25/25 green. make verify = regress + regress-rand.
2026-07-03 feat(rtl): split memory/MMIO port addressing + 2-wide retire strobe (OoO prep, D013)
    imem gains a second fetch port (2-wide frontend); dmem and mmio get
    independently-addressed read/write ports (the OoO core executes a load
    while the store queue commits an older store). The in-order top ties
    both addresses to the same MEM-stage signal — behavior is unchanged and
    verified: regress 9/9, quartus_map 0 errors. csr_file retire strobe
    widens to a 0..2 count for 2-wide retirement.
    docs/OOO.md is the binding spec for the OoO modules; DECISIONS.md D013
    records the five structural choices and the alternatives considered.
    [cpu_pipeline.v, csr_file.v, dmem.v, imem.v, mmio.v]
2026-07-03 feat(rtl): 2-wide out-of-order core - 1.397 CoreMark/MHz, IPC 1.008 (D013)
    New rtl/ooo/: a complete 2-wide OoO RV32I+Zicsr core (ooo_cpu) as a
    drop-in top beside the in-order baseline. docs/OOO.md is the binding
    spec; DECISIONS.md D013 records the choices and alternatives.
    Microarchitecture: R10K-style merged PRF (64 physregs, p0==0), RAT +
    32-tag free-list ring, 8 per-branch RAT/freelist/GHR/RAS-TOS/SQ-tail
    checkpoints (freed at retire, so out-of-order branch resolution needs no
    special casing), 32-entry ROB (2-wide dispatch/retire, stores result
    values for lockstep), unified 16-entry IQ (oldest-first select up to 3:
    branch/ALU/mem ports; select-time wakeup for 1-cycle ops -> zero-bubble
    d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
    [gshare_bp.v, ooo_cpu.v, ooo_decode.v, ooo_iq.v, ooo_prf.v, ooo_sq.v, sim_main.cpp]
2026-07-03 feat(npu): 4x4 int8 systolic array, MMIO 0x5xxxxxxx, MLP 86x/56x speedup (D014/D015)
    Output-stationary 4x4 int8 systolic array (rtl/npu/: npu_pe, npu_array,
    npu_top) hanging off the memory port of BOTH cores; docs/NPU.md is the
    binding spec. One GO streams a 4x4x4 tile in 10 cycles; accumulators
    persist across GOs (K tiling); all reads side-effect-free.
    Ordering is enforced in hardware, software never polls:
    - OoO: IO-region loads replay until every older store drains (new SQ
    q_older) and, for the NPU, until busy_next clears; the SQ drain
    backpressures into a busy NPU (mw_ready; harness snoops mw_fire).
    Fixes latent B010 (SQ forwarding shadowed MMIO reads).
    - In-order: NPU accesses st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
    [cpu_pipeline.v, id_ex_reg.v, iss.h, npu_array.v]
2026-07-07 docs: showcase README — out-of-order core, NPU, verification, measured results
    Rewrite the front page to lead with the full SoC and its measured
    results (in-order baseline -> +18.8% OoO -> 86x NPU speedup -> 11 bugs
    found under lockstep) instead of only the original 5-stage core.
    Preserves the demo video, badges, and author block.
2026-07-07 feat(mem): synchronous-read dmem for M9K inference (B006 increment 1)
    Data memory now supports a registered read via a new SYNC_READ parameter,
    the pattern Quartus needs to map the array to a MAX10 M9K block instead of
    ~8k logic FFs. The in-order core opts in (SYNC_READ=1); the OoO core keeps
    combinational reads for now (its memory rework is a later stage), so it is
    byte-for-byte unchanged on the read side.
    Key property: IPC-neutral. Synchronous BRAM adds exactly one cycle of read
    latency, but the in-order pipeline already had a MEM/WB register on the
    memory-data path. That latch is folded into dmem's read register, so the
    load result still lands in WB at the same cycle it did before -- loa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
    [cpu_pipeline.v, dmem.v, mem_wb_reg.v]
2026-07-07 feat(mem): synchronous-fetch imem for M9K inference (B006 increment 2)
    Instruction memory gains the same SYNC_READ parameter as dmem. The in-order
    core opts in (SYNC_READ=1); the OoO frontend keeps combinational fetch
    (default 0), so it is unchanged bar the new .clk/.hold ports tied off.
    Fetch fold: imem's registered output IS the Decode-stage instruction, so the
    former IF/ID instruction latch is removed (if_id_reg becomes a pc/valid/
    predictor control register). A wrong-path or reset-startup slot is squashed
    to a NOP in cpu_pipeline via the existing pipeline valid bit — the same job
    IF/ID's old flush->NOP path did. IPC-neutral: the mispredict penalty stays
    2 cycles.
    Critical stall subtl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
    [cpu_pipeline.v, if_id_reg.v, imem.v, ooo_cpu.v]
2026-07-07 feat(mem): single-read-port synchronous imem + M9K-inference notes (B006)
    Refines the synchronous imem after the Quartus check:
    - SYNC_READ=1 path now uses a SINGLE read port (the in-order core never
    reads instruction2); instruction2 is tied off. An initialized two-read-
    port RAM cannot take its MIF on MAX 10.
    - Synthesis init is $readmemh-only; the NOP-fill loop is simulation-only
    (a procedural fill mixed with $readmemh also blocks MIF generation).
    Quartus 20.1 A&S (in-order top, de10_top -> cpu_pipeline): 0 errors.
    - dmem inferred as block RAM (altsyncram, byte-lane split) -- the ~8k-FF
    store is now M9K. Dedicated logic registers 12,499 -> 5,472.
    - imem is left as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
    [imem.v]
2026-07-07 docs: log B006 progress, B012 fetch-hold bug, and decision D016
    - B006: PARTIALLY FIXED — dmem infers block RAM (12,499→5,472 registers);
    imem left as logic (MAX 10 initialized-ROM MIF limitation), M9K-ready
    and off the async critical path, block-RAM ROM deferred to the on-board
    large-program stage.
    - B012: synchronous fetch dropped the stalled instruction; fixed with a
    hold enable on imem's read register (found by lockstep).
    - D016: synchronous-read memories folded into the pipeline (IPC-neutral).
2026-07-07 feat(fpga): PLL clock + real SDC — timing closure at 50 MHz (B005/D017)
    Replace the free-running ripple-counter "clock" (cpu_clk = div[25]) that
    clocked the CPU with a PLL-generated global clock, and add the project's
    first real .sdc. This is the prerequisite for any honest Fmax.
    - rtl/top/pll.v: MAX 10 ALTPLL wrapper, CLOCK_50 (50 MHz) -> c0 (50 MHz,
    1:1) + locked. Instantiated directly so the clocking is self-contained
    and version-controlled (no generated IP blob); Quartus recognizes the
    altpll megafunction natively.
    - rtl/top/de10_top.v: CPU now runs on the PLL output; reset held until PLL
    lock, then the KEY[0] pushbutton double-flopped into the CPU domain.
    Ripp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
    [de10_top.v, pll.v]
2026-07-07 feat(demo): self-paced LED walker for the 50 MHz PLL clock (B005/D017)
    The CPU now runs at full 50 MHz (no slow ripple clock), so the demo paces
    itself: a single lit LED walks LED0->LED9->LED0 with a ~0.2 s software delay
    loop between steps. Pure bare-metal, entry at address 0, loops forever;
    drives the LED MMIO at 0x4000_0000. Replaces the pre-built led_demo.hex blob
    (which relied on the slow clock) as imem's synthesis default.
    `make demo` rebuilds sw/demo/led_demo.hex from led_demo.S via the standard
    .S->.elf->.bin->.hex flow. Disassembly verified.
2026-07-07 docs: close B005 (timing), add decision D017 (PLL + SDC)
    - B005 FIXED: PLL clock + real .sdc → Fmax 53.95 MHz, meets 50 MHz with
    +1.466 ns slack (was −13.05 ns). Made closable by B006 sync memories.
    - D017: PLL + SDC + self-paced demo; frequency confirmed by STA.
2026-07-07 docs: update Current status — B006 + B005 done for the in-order core
    Branch bram-mem-sync: dmem block RAM, sync fetch (B012 fixed), PLL + .sdc,
    Fmax 53.95 MHz @ 50 MHz. Both cores lockstep-verified. Pending review/merge.
2026-07-07 feat(ooo): synchronous-read dmem for the OoO core (board port, increment 1)
    Give ooo_cpu the same block-RAM data memory as the in-order core
    (SYNC_READ=1). The +1 read-latency cycle is absorbed by folding into the
    existing writeback register, exactly like the in-order core:
    - The load-result mux is split: SQ-forward / MMIO / NPU stay combinational
    in the memory slot and are captured into wb_val[2] at EX->WB; the RAM
    read (dmem_rdata) is now a registered WB-stage signal.
    - A new wb2_use_dmem bit (registered with wb_val[2]) selects, in WB, the
    dmem read for a plain RAM load. wb_result2 = wb2_use_dmem ? dmem_rdata :
    wb_val[2] feeds the three consumers (PRF write, EX bypass,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
2026-07-07 feat(fpga): OoO core on the board at 7.14 MHz (board port, increment 2)
    Switch the FPGA top from cpu_pipeline to ooo_cpu (drop-in, same interface)
    and clock it at 50/7 = 7.14 MHz.
    Why 7.14 and not 50: STA on the OoO core shows Fmax 8.42 MHz, and the
    critical path is entirely inside the issue queue —
    ooo_iq:IQ0|u[0][134] -> ooo_iq:IQ0|r2[9], 118.7 ns (slack -98.7 ns @50MHz).
    That's the un-pipelined select + wakeup + broadcast cloud across 16 IQ
    entries — the classic OoO Fmax limiter — on MAX 10's budget fabric. imem/dmem
    are not on it. Raising Fmax needs scheduler pipelining (a separate stage that
    changes IPC); the pragmatic board bring-up clocks the core under 8.42 MHz
    with margin i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
    [de10_top.v, pll.v]
2026-07-07 docs: record OoO board port + issue-queue Fmax finding (D018)
    - D018: OoO core on the board — dmem SYNC_READ load fold (IPC-neutral),
    de10_top -> ooo_cpu, Fmax 8.42 MHz (issue-queue select-wakeup critical
    path), clocked at 7.14 MHz (timing MET +9.35 ns), walker runs live.
    - CLAUDE.md status: both cores hardware-confirmed (in-order @50 MHz merged
    + tagged v3.1; OoO @7.14 MHz on branch). Lesson: perf = IPC x Fmax.
    - Next re-prioritized: IQ select-wakeup pipelining is the real fix.
2026-07-08 feat(ooo): balanced-tree issue-queue select (IQ pipeline increment 1a)
    Replace the 16-deep serial oldest-first min-chain in ooo_iq pick() with a
    balanced log-depth reduction tree (16->8->4->2->1, ~4 combine levels). The
    serial ripple was the dominant term in the OoO critical path (the 8.42 MHz
    Fmax cap, D018). The tree returns a BIT-IDENTICAL grant index: cmb2 keeps
    the older candidate and, on an age tie, the lower-index (left) operand,
    exactly reproducing the serial loop's strict `<` tie-break.
    IPC-neutral by construction and verified so: hello.c cycles/instret
    unchanged (1914/1882, IPC 0.983); OoO 12/12 regress + 40/40 riscv-tests +
    25/25 random seeds all lockstep-clean, zero divergence.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
    [ooo_iq.v]
2026-07-08 feat(ooo): parallel port-1 select, unchain from port-0 (IQ pipeline 1b)
    port1's pick previously scanned elig_alu_m1 (elig_alu minus gr0_i), so it
    could not begin until port0's grant resolved — two age-scans in series, the
    second long pole after 1a. Compute oldest AND second-oldest ALU in parallel
    (the 2nd is a find-first over elig_alu with the 1st winner's one-hot
    cleared) and resolve port1 with a terminal mux: substitute the 2nd-oldest
    only when port0 actually took the 1st-oldest ALU entry. Preserves the exact
    set semantics (port1 = oldest ALU/CSR excluding port0's actual grant;
    branch-on-port0 is a no-op exclusion; CSR-oldest still lands on port1).
    IPC-neutral and verified: hello.c 1914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
    [ooo_iq.v]
2026-07-08 feat(fpga): retarget OoO PLL to 16.67 MHz; log D019 (IQ Fmax 8.42->19.65)
    The D019 tree/parallel-pick issue-queue rewrite lifted OoO STA Fmax from
    8.42 to 19.65 MHz (slow-85C, 2.33x, IPC-identical). Retarget the board PLL
    50 MHz /7 -> /3 = 16.67 MHz, ~15% under Fmax; timing MET at 16.67 MHz with
    +18.9 ns slack, fitter 0 errors, 44,422 LEs. .qsf pins untouched (only
    pll.v divide + comment). D019 decision recorded with the interview-grade
    lesson: perf = IPC x Fmax; OoO needs ~42 MHz just to tie the in-order
    50 MHz core, so the deeper pipelined scheduler is scoped as future work.
    [pll.v]
2026-07-08 wip(ooo): speculative loads + load queue — recovery ~95%, 1 bug left
    WORK IN PROGRESS (D020, LQ increment 1). NOT merge-ready. Full state and the
    remaining-bug root-cause analysis are in docs/LQ_WIP_HANDOFF.md.
    Implemented and WORKING (happy path fully green — 14/14 regress + 25/25
    random lockstep-clean; directed violation test sw/tests/lq_violation.S PASSES
    with the poison+flush-at-head recovery active):
    - ooo_lq.v: 8-entry load queue + store->younger-load violation CAM.
    - ooo_iq.v: SPEC_LOADS param (default 1) relaxes the conservative load gate
    so loads issue before older store addresses are known.
    - ooo_cpu.v: architectural RAT (arat), rob_poison/rob_ld, violation->poison,
    multi-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
    [ooo_cpu.v, ooo_iq.v, ooo_lq.v, ooo_sq.v]
2026-07-08 docs: update Current status — Task 1 done (IQ Fmax 2.33x), Task 2 LQ WIP
    Session 2026-07-08 summary in CLAUDE.md: D019 IQ tree-select pipelining
    (Fmax 8.42->19.65 MHz, IPC-identical, board @16.67 MHz) DONE; D020 speculative
    loads + LQ ~95% (happy path green, ld_st bug open — see LQ_WIP_HANDOFF.md).
2026-07-08 fix(ooo): clear the IQ on load-violation flush-at-head (B013) — LQ complete (D020)
    The `ld_st` riscv-test failed under speculative loads because the
    load-ordering-violation flush-at-head never cleared the issue queue. It
    reused the branch-mispredict path with `flush_tag = head_tag - 1`,
    intending "everything is younger than head-1, clear all" — but the age
    predicate is `(tag - head) > (flush_tag - head)`, and `(head-1) - head`
    is 6'd63; since relage is a 6-bit value in [0,63], `relage > 63` is
    always false, so ZERO entries were cleared. Surviving pre-flush IQ
    entries re-issued after the freelist rebuild with their old ps1/ps2
    (physical regs since reallocated), and a stale copy of a load-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
    [ooo_cpu.v, ooo_iq.v]
2026-07-08 docs: record ooo-iq-pipeline merge to main + FPGA board top now OoO@16.67MHz
    Task 1 (D019) + Task 2 (D020) merged (dbc0ecc). de10_top now instantiates
    ooo_cpu @16.67 MHz (was in-order @50 MHz). Both cores verified on merged
    main; quartus_map 0 errors. Next steps + the MSYS-make TMP env gotcha noted.
2026-07-09 refactor(ooo): unify IQ mem gate on wait-mask==0; add LOAD_POLICY param (D021 inc 0)
    The IQ no longer knows the speculation policy: elig_mem = ready && is_mem
    && (mask==0) uniformly for loads AND stores, and the SPEC_LOADS parameter
    is gone. The policy lives in the mask VALUE ooo_cpu dispatches: policy 0
    = conservative full older-unknown-store mask (== D020 SPEC_LOADS=0),
    policy 1 = 0 (== D020 SPEC_LOADS=1), policy 2 = one-hot store-set
    prediction ANDed with the conservative mask (predictor lands next).
    Verified cycle-identical both ways: hello.c exactly 2613 cyc (policy 1)
    / exactly 1921 cyc (policy 0); OoO 14/14 + 40/40 + 25/25 + 25/25 --vio
    lockstep-clean; in-order 14/14 + 40/40 + 25/25;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
    [ooo_cpu.v, ooo_iq.v]
2026-07-09 feat(ooo): store-set predictor module + unit TB (D021 inc 1)
    ooo_stset.v: Chrysos & Emer SSIT (64x{v,ssid}, pc[7:2]-indexed) + LFST
    (16x{v,sqpos}) with the paper's merge rules (fresh/share/min), same-cycle
    slot1 LFST bypass for co-dispatched pairs, 2^16-cycle cyclic decay, and a
    port-sharing training cycle (the two SSIT lookup ports are borrowed on
    the registered apply cycle - a one-cycle hint blackout inside the ~46-cyc
    violation flush). LFST names an SQ slot, not an inum: the IQ mask
    machinery turns it into a wait, and sq_unknown makes store-execute
    invalidation implicit.
    stset-tb: standalone Verilator TB vs a C++ golden model - directed merge/
    bypass/decay/alias cases + 200k random inter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
2026-07-09 feat(ooo): integrate store-set predictor, LOAD_POLICY=2 default (D021 inc 2)
    Dispatch-time integration: R-stage SSIT/LFST lookups on dr_pc*[7:2] feed
    one-hot pred masks ANDed with the conservative mask0/mask1 (the INV-P1
    safety bracket); predicted stores wait too (in-set store->store ordering);
    2-phase training (capture at the LQ CAM hit with the poison write's
    wrong-path gates, apply next cycle - zero logic after the D020 critical
    path). Policy 3 (Alpha 21264 1-bit stWait style) added as a measured
    comparison config. Sim invariants: mask-subset / one-hot / no-self-wait,
    mask-bits-only-on-live-unknown-SQ-slots (via a new unknown_raw debug port
    through ooo_sq->ooo_iq), training-reads-live-ROB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
    [ooo_cpu.v, ooo_iq.v, ooo_sq.v]
2026-07-09 docs+measure(ooo): D021 results — STA char, board-capacity finding, SSIT_AW escape (inc 3)
    - DECISIONS.md D021: 4-policy measured table finalized; Fmax/LE section
    filled — seed-3 fit 48,302 LEs (97%), net +64 LEs/+160 regs vs D020;
    predictor lookup 19.2 ns, NOT on the critical path (core Fmax 19.55 MHz
    = pre-existing dmem-load->bypass->JALR->BTB path, 80% routing at the
    96-97% capacity cliff; 4 of 5 fit attempts failed to place, incl. an
    SSIT=32 trial -> table size doesn't decide the fit).
    - BOARD FINDING (pre-existing): de10_top no longer fits the 10M50 —
    predictor-free main maps to 51,225 LEs (103%); over capacity since the
    D020 LQ merge (gate was map-error-count only).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
    [stset_tb.cpp]
2026-07-10 feat(build): hex->MIF even/odd bank splitter for imem M9K init (D022 inc 0)
    scripts/hex2mif.py splits a flat $readmemh image into imem_even.mif /
    imem_odd.mif (word i -> bank i&1 @ i>>1), NOP-pads to full depth (matches
    the Verilator arm, closes the zero-vs-NOP sim/board divergence), and
    --check round-trips both MIFs back against the padded image. make mif
    generates them; demo depends on it; MIFs checked in like sw/demo/*.hex.
2026-07-10 feat(mem): imem_banked - even/odd single-port M9K ROM pair (D022 inc 1)
    Two 512x32 banks, word i in bank i&1 @ i>>1; pc/pc+4 always oppose in
    parity so each single-port bank serves one fetch slot per cycle. Output
    crossbar selects on the parity REGISTERED with the read (sel_q). Banks
    carry ram_init_file attributes (imem_even/odd.mif); no initial block in
    the Quartus path - the MIFs are the sole initializer (B006 workaround).
    Verilator arm splits the flat +imem hex and arms INV-F1: every captured
    pair is checked against the flat shadow image. Added to the qsf file
    list; stale top-is-cpu_pipeline comment fixed. Lint clean both sizes;
    quartus_map 0 errors with the entity parsed.
    Co-Authored-By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
    [imem_banked.v]
2026-07-10 feat(ooo): fold F/D instruction regs into banked M9K imem (D022 inc 2)
    ooo_cpu fetch: imem_banked replaces the combinational dual-port imem;
    rd_en = fd_accept is the whole contract (every edge that sets fd_v* also
    captures mem[pcF]; redirects null the valids, so stale captures are never
    consumed - mispredict penalty unchanged). fd_i0/fd_i1 deleted as regs;
    the ROM read registers ARE the F/D instruction pair.
    imem_banked synthesis arm reworked to explicit altsyncram ROMs after the
    attribute path failed: B006 root cause is NOT a family limitation but the
    missing MAX 10 ERAM internal-configuration mode (Error 16031) - one qsf
    line, INTERNAL_FLASH_UPDATE_MODE = SINGLE COMP IMAGE WITH ERAM, unlo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
    [imem_banked.v, ooo_cpu.v]
2026-07-10 docs: D022 entry, B006 FIXED with real root cause, status update (D022 inc 5)
    D022: imem -> even/odd banked M9K ROM, the OoO F/D fold exactness
    argument, the ERAM internal-configuration-mode discovery, the corrected
    capacity math (old imem constant-folded to 98 LEs; gshare_bp 9,354 LEs is
    the real pig), full verification + board numbers (48,153 LEs / 97%, M9K
    11/182, +6.34 ns @ 16.67 MHz, .sof rebuilt). B006 closed after three
    sessions: the MIF-not-supported message was the missing ERAM mode all
    along. CLAUDE.md status + Next refreshed (flash step pending hardware).
2026-07-11 docs: D022 hardware-confirmed on DE10-Lite - LED walker live at 16.67 MHz
    Hanna flashed the .sof via the Quartus Programmer GUI; the walk proves the
    banked M9K imem, parity crossbar and ERAM config mode on real silicon.
    B006 closed end-to-end (sim, STA, silicon).
2026-07-11 docs: pof programmed+verified - board boots the CPU standalone from CFM
2026-07-11 feat(mem): D023 inc 0 - dmem 64KB explicit altsyncram M9K with MIF init, imem 8KB
    dmem SYNC_READ arm becomes a simple-dual-port altsyncram (byte-enabled
    write port, registered-address read port, OLD_DATA mixed-port RDW) init
    from synth/dmem.mif - the D022 ERAM recipe applied to RAM, which is what
    lets a board program find its .data at power-up. Behavioral arm and the
    shared byte-enable write logic unchanged. hex2mif.py gains --single for
    the unbanked dmem image.
2026-07-11 feat(soc): D023 inc 1 - 7-segment display MMIO path end to end
    mmio gains HEXLO/HEXHI (0x4000000C / 0x40000014): one raw active-low
    segment byte per digit, software owns the font (rv32.h). Wired through
    both cores and de10_top; DE10-Lite HEX0-5 pins ADDED to the qsf
    (additive only, verified against two independent board references).
    ISS mirrors both registers so every HEX access is lockstep-compared;
    new directed test hex_mmio.S. Harness gains +sw= to drive the board
    switches in sim (ISS kept in step).
2026-07-11 feat(sw): D023 inc 2 - MLP board demo program, board link script, MIF flow
    mlp_board.c: NPU-only classify, self-test on images 0-7 (= the sim
    regression, PASS both cores, 8/8 correct, lockstep-clean), then the
    board-only switch loop: SW[2:0] selects the image, HEX5/HEX2/HEX0 show
    image/label/prediction, LEDR9 = correct. link_board.ld makes the real
    8KB/64KB memories a link-time constraint. make mif now emits the MLP
    imem banks + dmem image (MIF_PROG=demo restores the LED walker);
    checked-in MIFs flip to the MLP demo. DECISIONS D023 logged.
2026-07-11 docs: README refresh through D023 + board demo guide (DEMO.md)
    README gains the FPGA chapter (perf = IPC x Fmax, B006 ERAM saga, flash
    boot), store sets, 14-bug count, violation-stress layer, and the MNIST
    demo marked sim-verified/flash-pending. Every number fact-harvested from
    the docs and adversarially verified by two independent reviewers; six
    findings fixed (incl. a per-inference latency mislabel and two
    overclaims about what is on silicon today).
2026-07-11 fix(synth): false-path the HEX0-5 display outputs (D023)
    Same class as LEDR - MMIO-registered human-eye outputs with no
    synchronous board interface; keeps STA at 0 unconstrained paths.
2026-07-11 docs: D023 status - demo complete + sim-verified, board fit blocked by routing; gshare shrink is next
2026-07-11 feat(tb): divergence diagnostics + measured RTL line coverage (audit 2026-07-11)
    Diagnostics — a lockstep mismatch now prints usable context instead of
    one line: 64-entry retired-instruction ring buffer (cycle/pc/writeback/
    store) + full ISS architectural register dump on every mismatch path
    (both cores, including the OoO store-stream compare). New plusargs:
    +trace_at=<cycle> opens the FST only at the given cycle (a waveform
    window for divergences deep into 500M-cycle runs — tracing from cycle 0
    is infeasible there), +force_diverge=<n> permanently self-tests the
    whole dump path (verified: exit 3 with ring + register dump on both
    cores; normal runs unaffected, regress smoke green).
    Cover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
2026-07-11 docs: 2026-07-11 audit report + truth fixes (blocked-not-pending, OOO.md banner)
    - docs/AUDIT-2026-07-11.md: the full verified audit — 36 confirmed
    findings across RTL area / timing / synthesis / verification / build /
    software / docs, with owners, evidence, and live checkboxes. Headline:
    ooo_prf (10,947 LCs) is TIED with gshare_bp (11,137) as the #1 LE pig,
    and the BTB is already M9K in the current build — the gshare shrink
    must target the PHT side. This file is the continuation roadmap.
    - README/DEMO.md: the MNIST board demo is BLOCKED by routing congestion
    (96% LEs, structural), not "flash pending" — a reader hitting "Can't
    route" now knows it is expected and what unbl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
2026-07-11 feat(synth): routing toolbox knobs + A/B'd area settings (audit 2026-07-11)
    Applied and kept (all verified in the fit/map settings tables):
    - NUM_PARALLEL_PROCESSORS ALL (was silently capping at 10/16 threads)
    - EDA_SIMULATION_TOOL "<None>" (ModelSim netlist export burned compile
    time + 45 MB synth/simulation per compile; project sims with Verilator)
    - ROUTER_TIMING_OPTIMIZATION_LEVEL MINIMUM + placement/router effort
    multipliers 4.0 — the toolbox for the D023 routing-congestion failure
    (timing margin is huge at 16.67 MHz; route completion is what matters)
    - AUTO_RESOURCE_SHARING ON (applies, LE-neutral on today's RTL, free
    on future RTL)
    A/B'd and REJECTED: OPTIMIZATION_TECHNIQUE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
2026-07-12 feat(soc): 2-flop synchronizer on the slide switches (audit fix, Hanna-approved)
    SW pins are asynchronous mechanical inputs feeding the CPU load path;
    the .sdc false-path silences STA but provides no metastability
    protection, and the D023 demo reads them in a loop. 20 reset-free
    registers; the read mux now returns the synchronized copy. Lockstep-
    invisible (harness drives switches statically; ISS mirrors a constant).
    Verified: 19/19 + 40/40 + 5/5-rand both cores; MLP demo self-test 8/8
    both cores (OoO cycle count unchanged).
    [mmio.v]
2026-07-12 feat(sw): link-time guard - board programs must not carry .data/.sdata (Hanna-approved)
    KEY0 warm reset restarts _start without reloading the dmem MIF (that
    happens only at device configuration); crt0 re-zeroes .bss but nothing
    can restore initialized writable data - a program relying on it would
    silently run its second pass on corrupted globals. link_board.ld now
    ASSERTs .data/.sdata are empty, turning that trap into a link error.
    .srodata moved into .rodata first (const data must not false-trigger;
    costs only gp-relaxation on small consts).
    Verified: mlp_board relinks clean through the assert (it genuinely has
    zero writable initialized data) and the regenerated MIFs are
    byte-identical to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
2026-07-12 chore(synth)+docs: drop redundant KEY assignment (Hanna-approved) + gshare shrink options
    - Removed the unindexed `-to KEY` IO_STANDARD duplicate inside the pin
    block (with Hanna's explicit approval - KEY[0]/KEY[1] keep theirs).
    It was the source of Warning 171167 "ignored invalid Fitter
    assignments" on every fit. No location assignment touched.
    - docs/GSHARE_SHRINK.md: the design-options sheet for the PHT->M9K
    shrink (Hanna picked gshare-only scope). Key finding: pidx0/pidx1
    always differ in bit 0 (pc+4 flips pc[2]; the ghr xor preserves
    parity), so the D022 even/odd imem banking applies verbatim to the
    PHT. Options: A = banked sync-read M9K PHT with a not-taken-blind
    first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
2026-07-12 fix(core): qualify load-use stall with real source-operand usage (Hanna-approved)
    hazard_unit compared instr[24:20]/[19:15] against a load's rd for EVERY
    format - but those bits are rs2 only in R-type/branch/store and rs1 is
    absent in LUI/AUIPC/JAL; elsewhere they are immediate bits, so e.g.
    `lw x7,...; addi a0,a1,7` stalled a cycle for nothing (the old BUGLOG
    watch-list quirk). New uses_rs1D/uses_rs2D opcode qualifiers gate the
    compares; SYSTEM/FENCE stay conservative (needless stall = safe,
    missed stall = bug).
    Measured honestly: the pattern is rare in gcc output - CoreMark
    510,044,732 cyc vs the 510,056,361 baseline (-0.002%, IPC 0.849
    unchanged, official CRCs + 432.9M instructions locks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
    [cpu_pipeline.v, hazard_unit.v]
2026-07-12 feat(ooo): gshare PHT -> even/odd banked M9K (D024) - 6,580 LEs freed, IPC kept
    The #1 (tied) LE pig from the 2026-07-11 audit: gshare_bp was 11,137 LCs,
    almost all PHT-side (the BTB was already M9K). The 1024x2 PHT read index
    pc[11:2]^ghr has no address register for Quartus to retime into a RAM, so
    the array stayed in fabric and was DUPLICATED per read port. Hanna chose
    option A1 (docs/GSHARE_SHRINK.md).
    Mechanism: two 512x2 M9K banks split on pidx[0]. For a fetch pair
    (pc, pc+4) the two indices ALWAYS differ in bit 0 (+4 flips pc[2]; the ghr
    xor preserves parity), so the slots never collide - the D022 imem even/odd
    trick applied to the PHT. The banks' address registers pre-load next-cycle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
    [gshare_bp.v, ooo_cpu.v]
2026-07-12 docs: D024 board fit SUCCESS - MNIST demo bitstream builds (88% LEs, timing met)
    The gshare->M9K shrink (D024) freed 6,580 LEs and unblocked the D023
    board demo that failed to route at 96% on 2026-07-11. Full board fit
    now: 43,609/49,760 LEs (88%), Fitter Successful 0 errors, timing MET at
    16.67 MHz with +16.8 ns slack (Fmax 23.16 MHz, up from D019's ~19.65 -
    the async PHT cloud left the frontend; new limiter is the D020
    dmem-load->rob_poison LQ path). .sof built; on-silicon flash is the
    remaining step (USB-Blaster, Hanna's).
    - DECISIONS.md D024: board-fit result appended.
    - README/DEMO.md: demo status blocked -> builds (bitstream + timing);
    flash pending.
    - AUDIT-2026-07-11.md: gshare sh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
2026-07-12 docs: docs/NEXT.md start-here backlog; flash deferred (Hanna's hardware step)
    The agreed next-tasks list, most-ready first: (0) flash the MNIST demo
    (.sof built, deferred to Hanna's board session), (1) PRF->M9K LVT,
    (2) 2-stage pipelined scheduler, (3) JALR target adder, (4) IQ payload
    split, (5) small infra cleanups. Owner-tagged per the division-of-labor
    rule. CLAUDE.md Next points here.
2026-07-12 feat(ooo): PRF -> 18 banked M9K blocks via LVT (D025) - 8,895 LEs freed, IPC-neutral
    ooo_prf rewritten from a 6R/3W 64x32 async-read fabric register file
    (10,947 LCs, the audit's second/last big LE pig) to the LaForest LVT
    construction: 18 M9K banks (6 read copies x 3 write banks) + a 64x2
    register LVT (owner-per-reg), with the read address FOLDED into the M9K
    address registers (fed the SEL-stage sel_uop[PS] tag, the D016/D022/D024
    fold) and a two-level direct+shadow write-first bypass rebuilding the async
    rd_bypass exactly over the M9K's OLD_DATA. RF read stage never stalls, so
    no hold needed (simpler than imem's B012). Single-assignment => <=1 bypass
    match (INV-P1). dmem-style dual arm (be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
    [ooo_cpu.v, ooo_prf.v, prf_tb.cpp]
2026-07-14 perf(ooo): balance LQ selector and fix slot1 allocation
    [lq_tb.cpp, ooo_lq.v]
2026-07-14 perf(ooo): cut load-WB bypass and raise board clock
